rmdcarney/CMBS4_SCSQUID_BiasBoard/pdf/ver3E_headOn.png

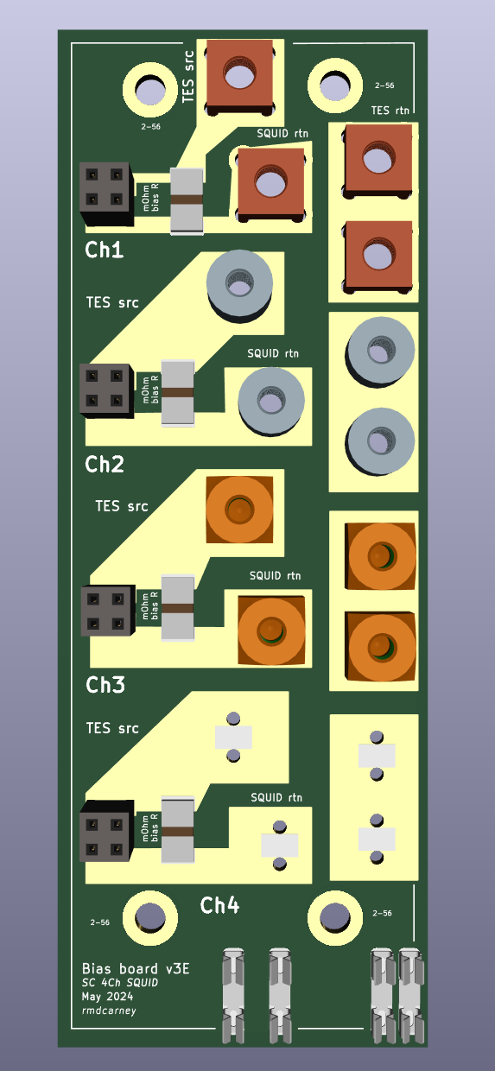
pdf/ver3E_headOn.png
