rmdcarney/CMBS4_SCSQUID_BiasBoard/pdf/ver3E_front.png

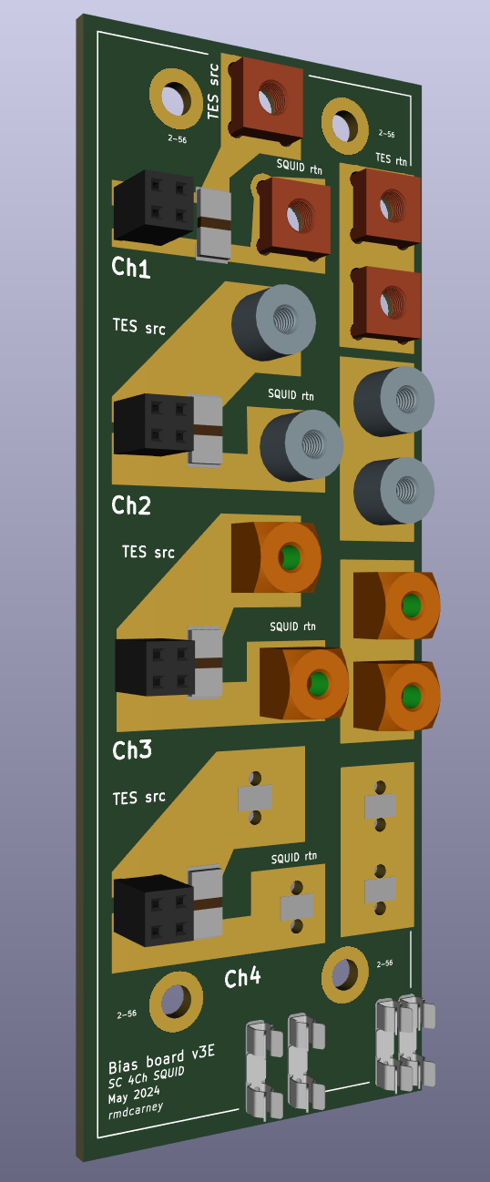
pdf/ver3E_front.png
