rmdcarney/CMBS4_SCSQUID_BiasBoard/pdf/ver3b_front.png

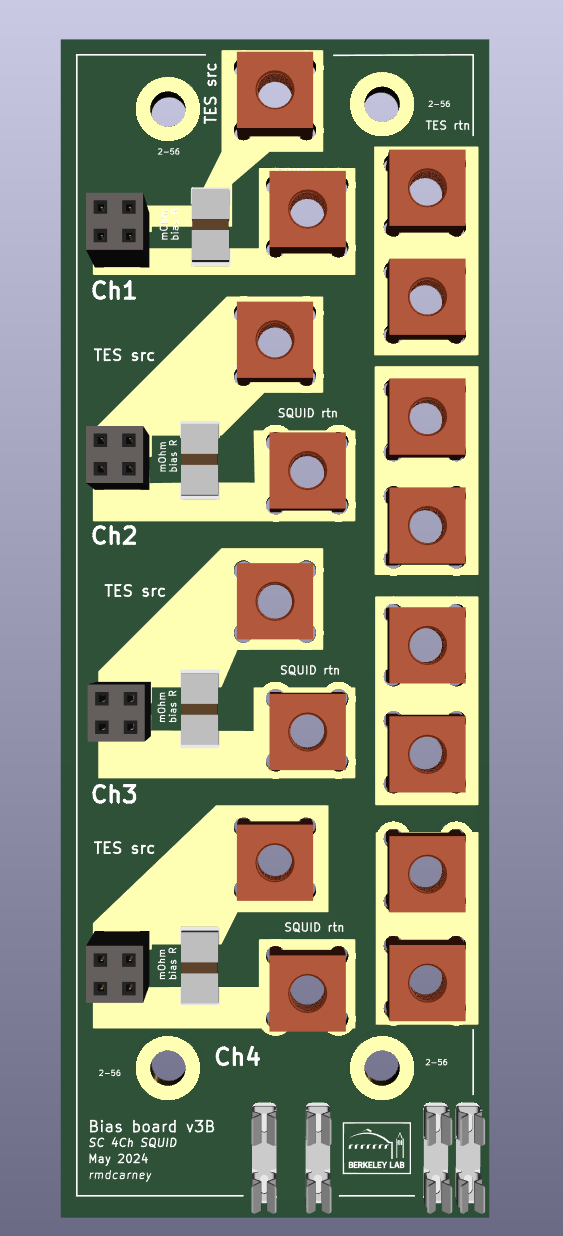
pdf/ver3b_front.png
