rmdcarney/CMBS4_SCSQUID_BiasBoard/pdf/ver3C_front.png

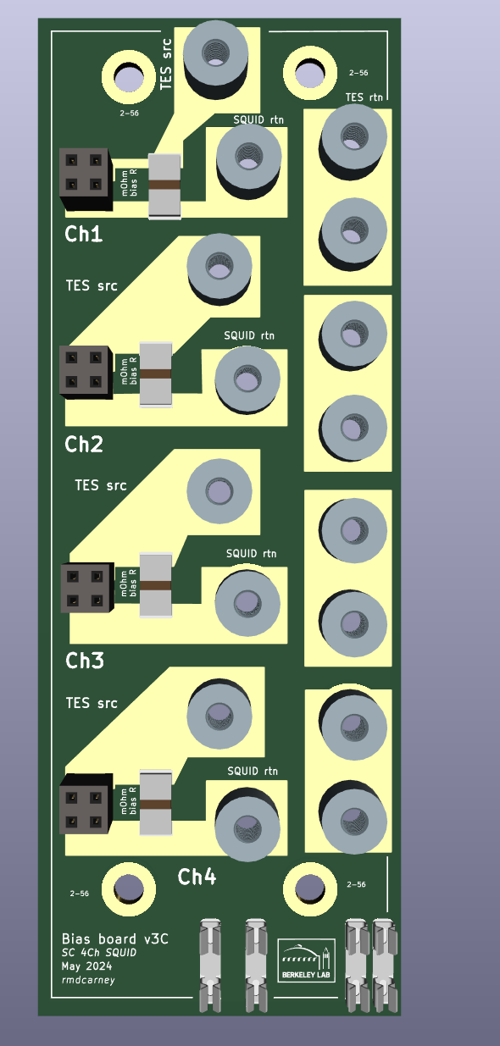
pdf/ver3C_front.png
