rmdcarney/CMBS4_SCSQUID_BiasBoard/pdf/ver3C_front_woConn.png

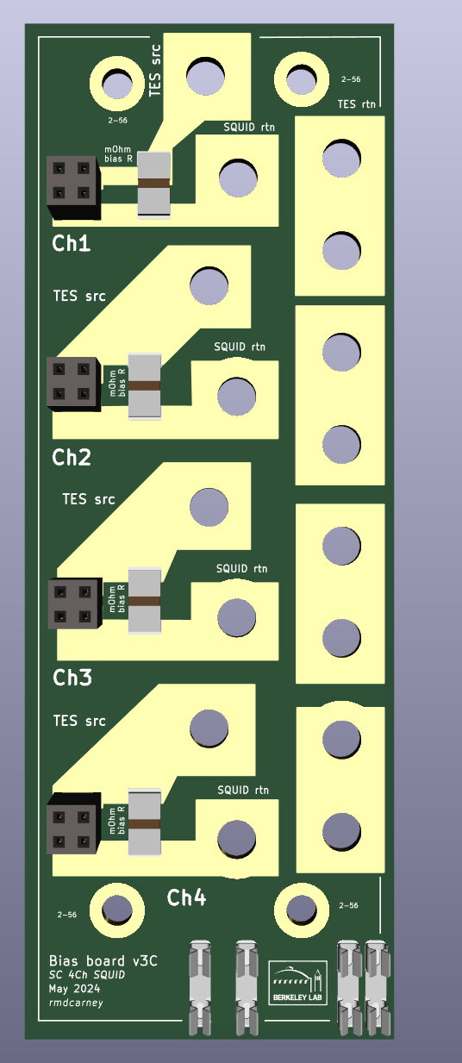
pdf/ver3C_front_woConn.png
