rmdcarney/CMBS4_SCSQUID_BiasBoard/pdf/ver3D_front.png

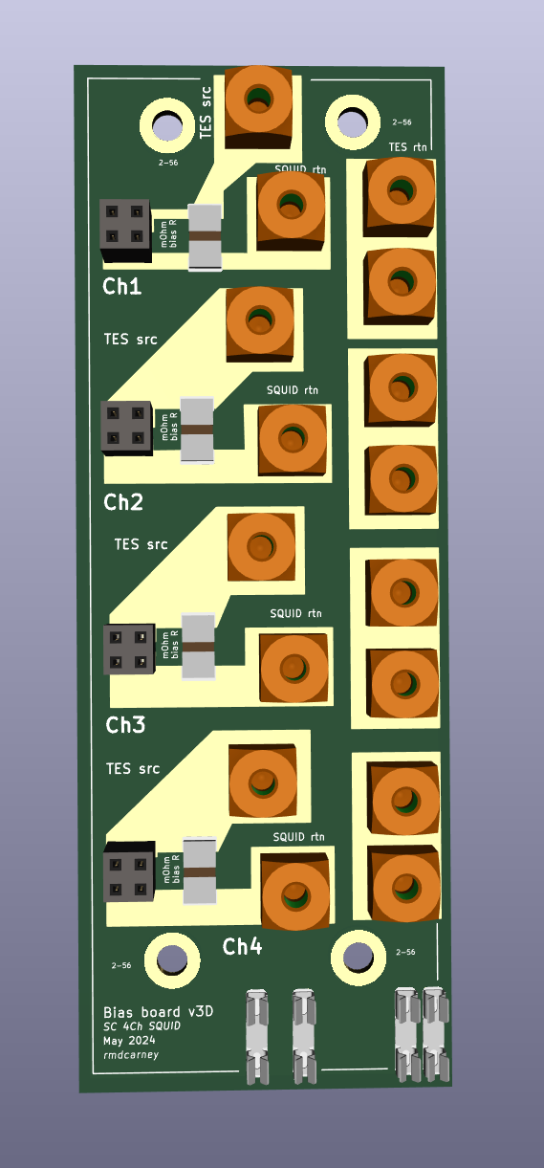
pdf/ver3D_front.png
