rmdcarney/CMBS4_SCSQUID_BiasBoard/pdf/ver3D_front_woConn.png

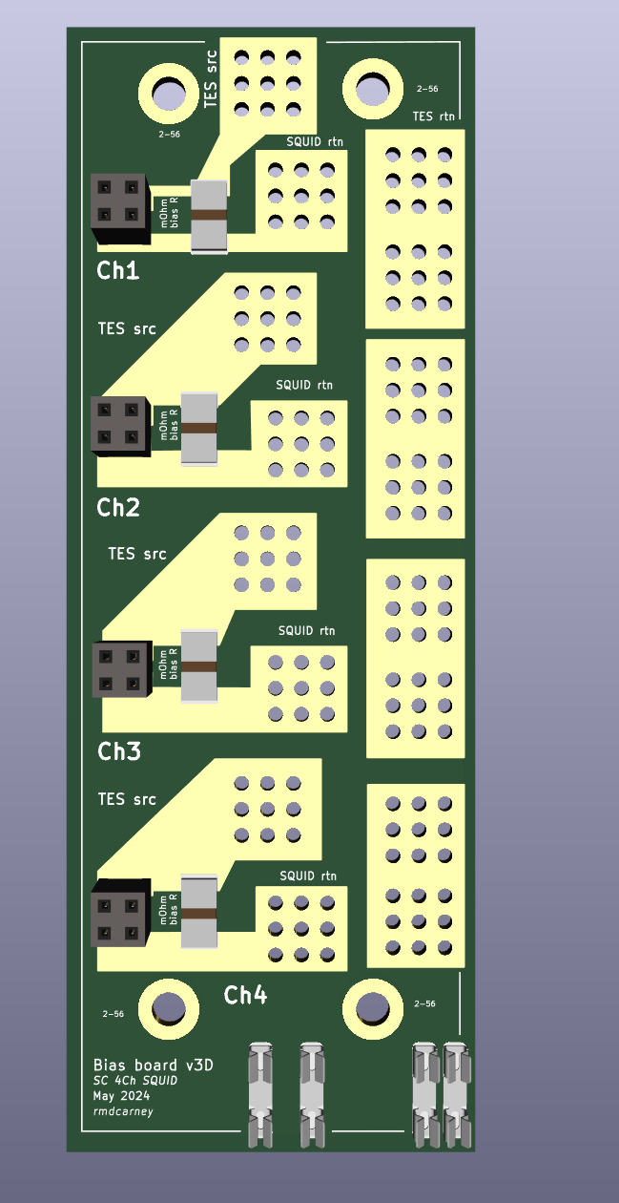
pdf/ver3D_front_woConn.png
