rmdcarney/CMBS4_SCSQUID_BiasBoard/pdf/ver3E_back.png

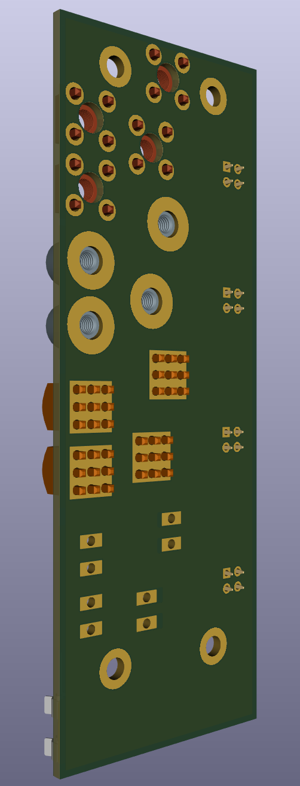
pdf/ver3E_back.png
