rmdcarney/CMBS4_SCSQUID_BiasBoard/3Dmodels/Download_STP_7466003_rev1.stp

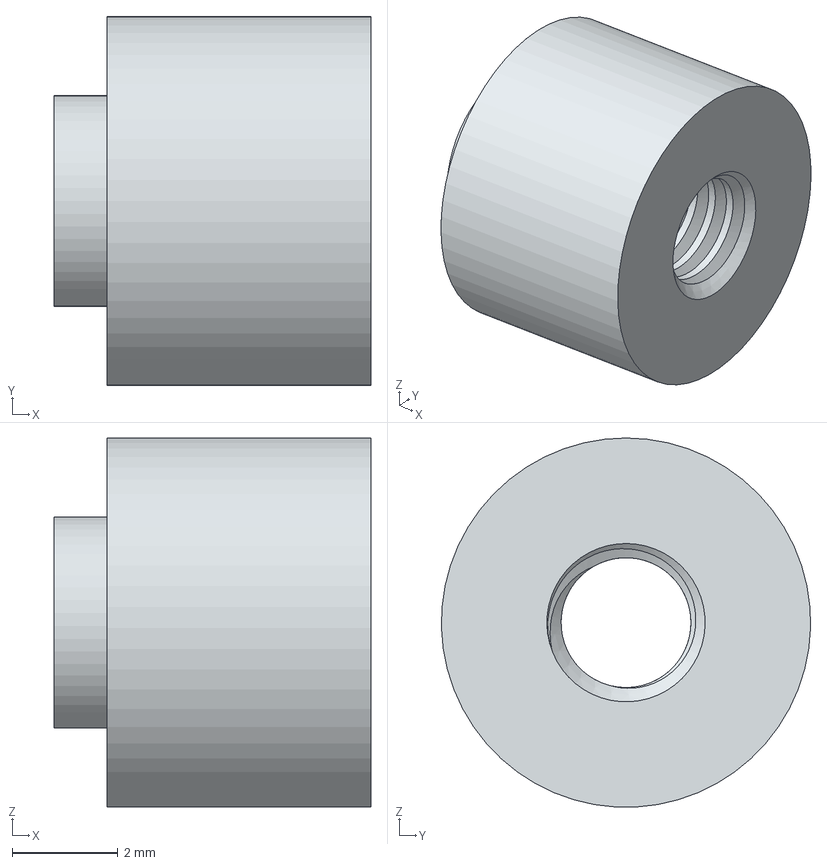
[picture p9: CAD file, 2024-06-01]
3Dmodels/Download_STP_7466003_rev1.stp
6.00 x 7.00 x 6.99 mm
