rmdcarney/CMBS4_SCSQUID_BiasBoard/3Dmodels/s1411-46r_BeBronze.stp

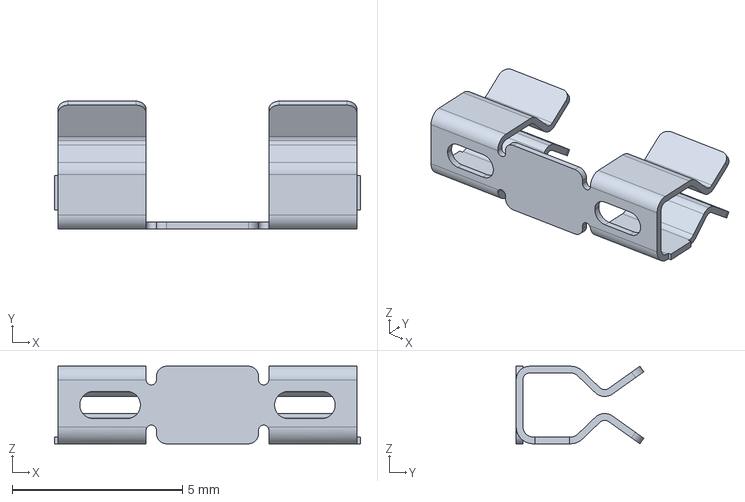
[picture p10: CAD file, 2024-05-31]
3Dmodels/s1411-46r_BeBronze.stp
8.99 x 3.75 x 2.28 mm
