rmdcarney/CMBS4_SCSQUID_BiasBoard/3Dmodels/s8101-46r_cableClipBe.stp

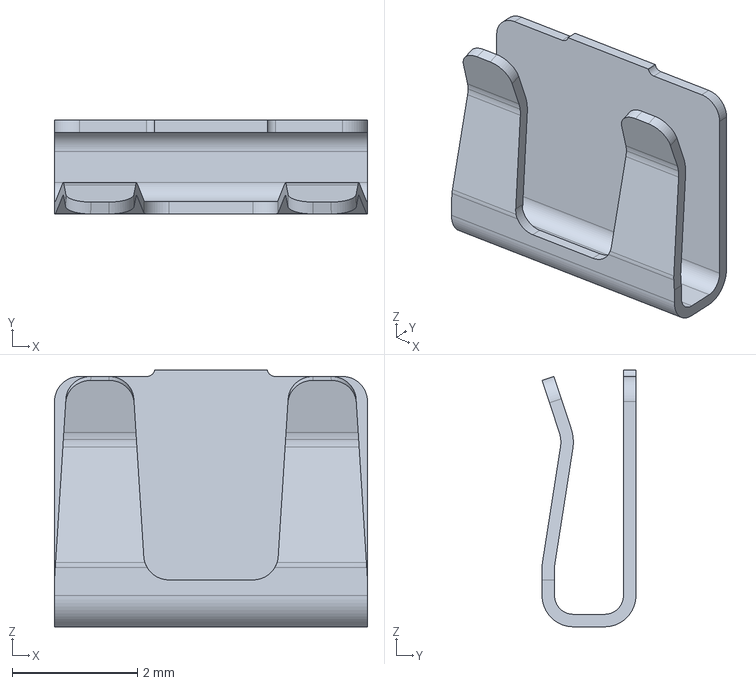
[picture p11: CAD file, 2024-05-31]
3Dmodels/s8101-46r_cableClipBe.stp
5.00 x 1.50 x 4.10 mm
