rmdcarney/CMBS4_SCSQUID_BiasBoard/3Dmodels/SC_SQUID_biasBoard_verA.STEP

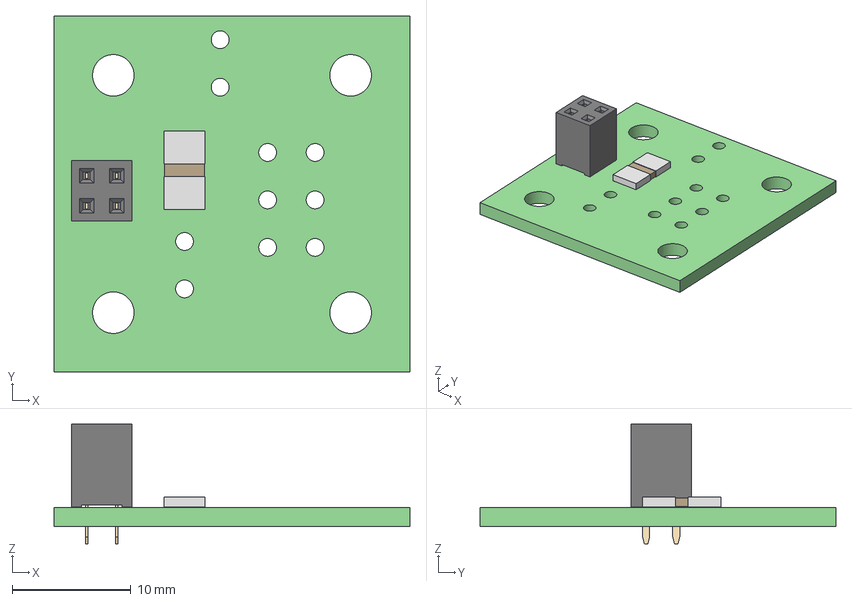
[picture p12: CAD file, 2024-05-31]
3Dmodels/SC_SQUID_biasBoard_verA.STEP
30.0 x 30.0 x 10.1 mm
SC_SQUID_biasBoard PCB
