rmdcarney/CMBS4_SCSQUID_BiasBoard/3Dmodels/RES_SCMM2512__5-_8mOHM_CYN.step

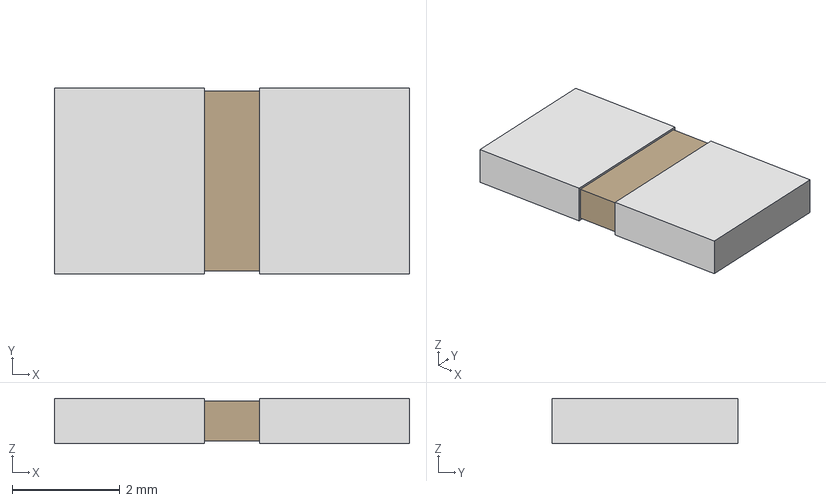
[picture p13: CAD file, 2024-05-31]
3Dmodels/RES_SCMM2512__5-_8mOHM_CYN.step
6.60 x 3.45 x 0.838 mm
