rmdcarney/CMBS4_SCSQUID_BiasBoard/3Dmodels/7461093_Download_STP_7461093_rev1.stp

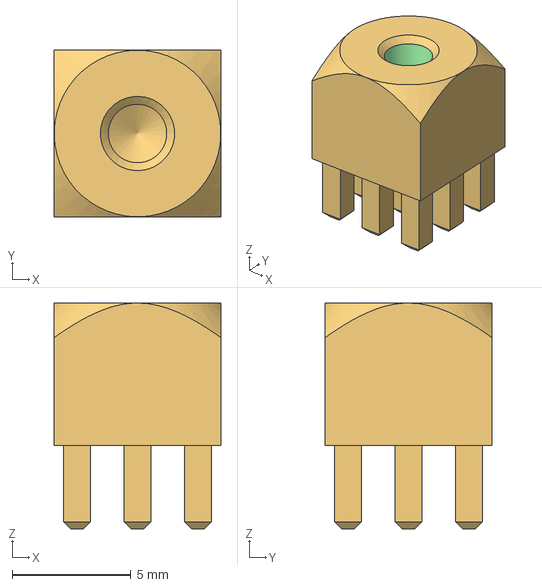
[picture p14: CAD file, 2024-06-01]
3Dmodels/7461093_Download_STP_7461093_rev1.stp
7.00 x 7.00 x 9.50 mm
