rmdcarney/CMBS4_SCSQUID_BiasBoard/3Dmodels/74650073_screwTermLegs.stp

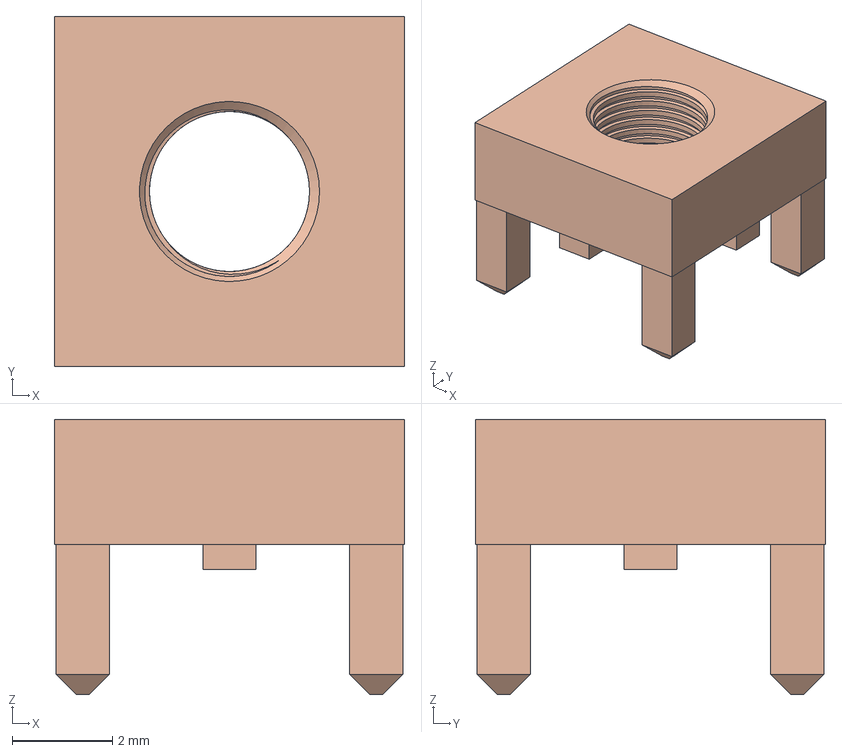
[picture p15: CAD file, 2024-05-31]
3Dmodels/74650073_screwTermLegs.stp
7.00 x 7.00 x 5.50 mm
