rmdcarney/CMBS4_SCSQUID_BiasBoard/gerber/SC_SQUID_biasBoard-F_Silkscreen.pdf

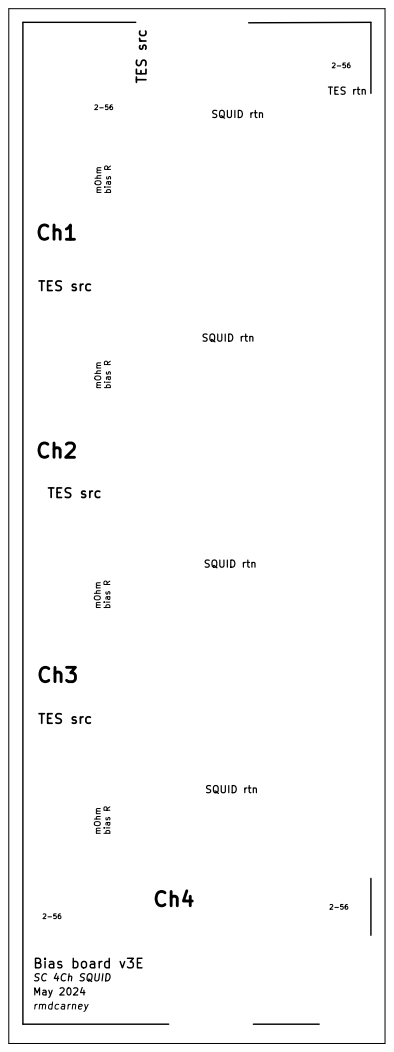
[picture p16: page 1]

2-56 TES src May 2024
TES rtn SQUID rtn Bias board v3E
rmdcarney mOhm bias R Ch3

mOhm bias R SC 4Ch SQUID Ch2
