rmdcarney/CMBS4_SCSQUID_BiasBoard/pdf/SC_SQUID_biasBoard_v3B_4Ch_schematic.pdf

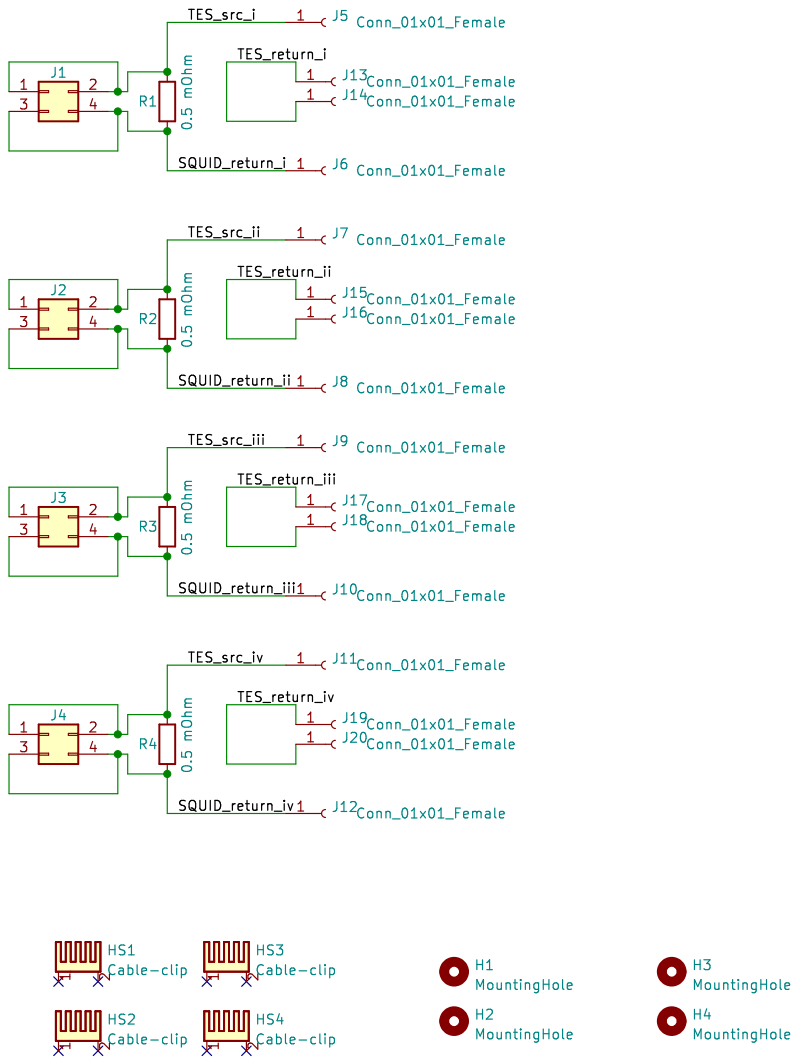
[picture p17: page 1]
