rmdcarney/CMBS4_SCSQUID_BiasBoard/gerber/SC_SQUID_biasBoard-B_Cu.pdf

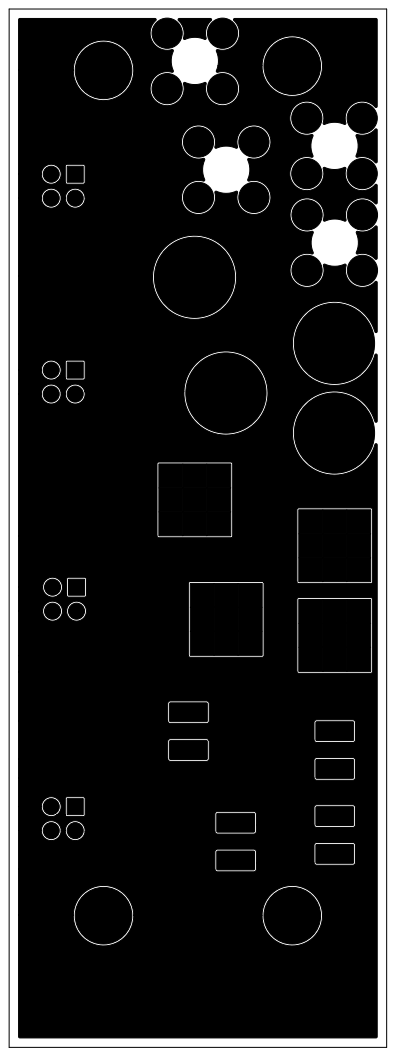
[picture p18: page 1]
