rmdcarney/CMBS4_SCSQUID_BiasBoard/gerber/SC_SQUID_biasBoard-B_Mask.pdf

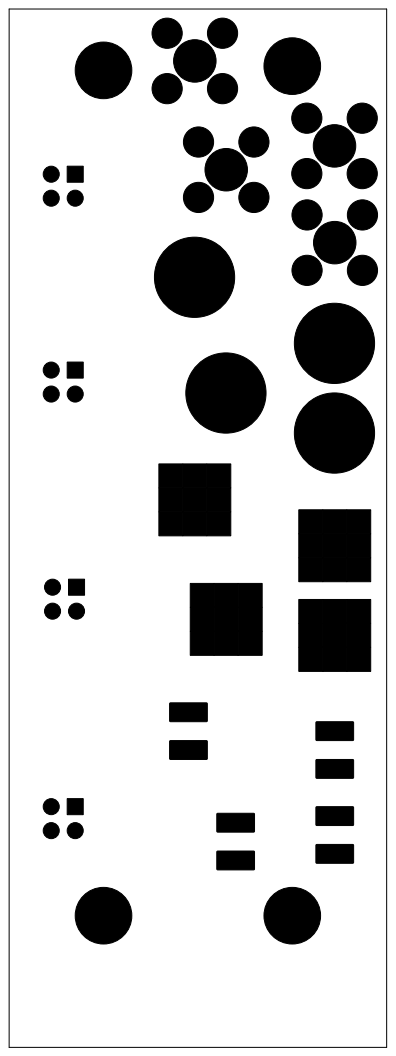
[picture p19: page 1]
