rmdcarney/CMBS4_SCSQUID_BiasBoard/gerber/SC_SQUID_biasBoard-F_Cu.pdf

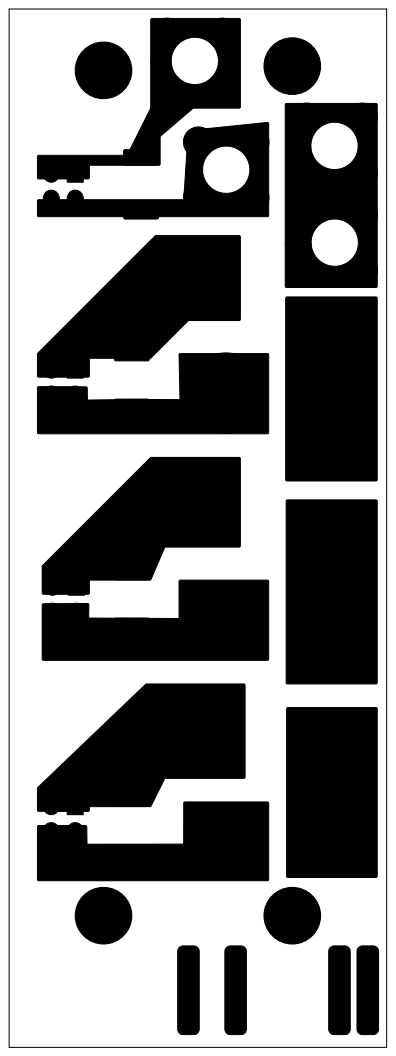
[picture p20: page 1]
