rmdcarney/CMBS4_SCSQUID_BiasBoard/gerber/SC_SQUID_biasBoard-F_Mask.pdf

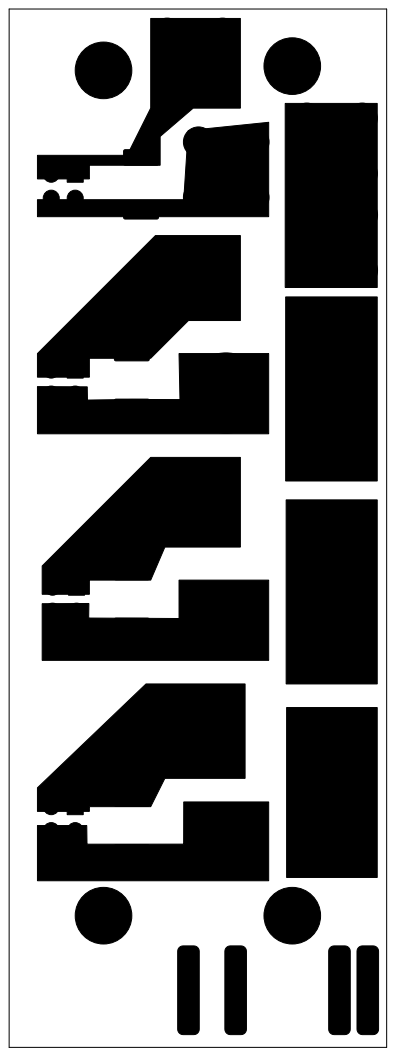
[picture p21: page 1]
