rmdcarney/CMBS4_SCSQUID_BiasBoard/gerber/SC_SQUID_biasBoard-User_Drawings.pdf

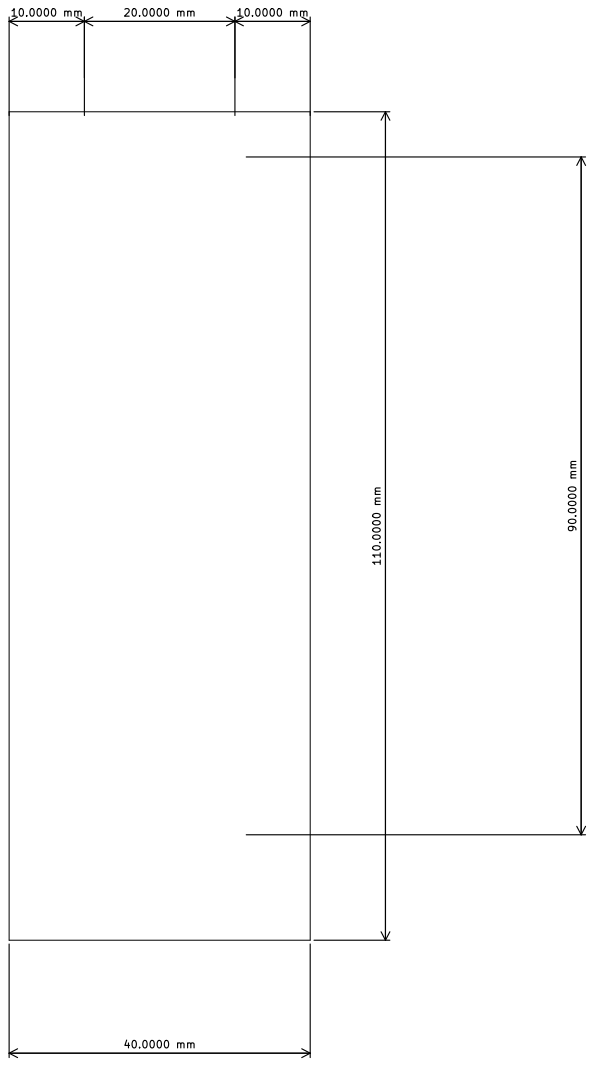
[picture p22: page 1]
