rmdcarney/CMBS4_SCSQUID_BiasBoard/pdf/SC_SQUID_biasBoard_v3D_4Ch_layout.pdf

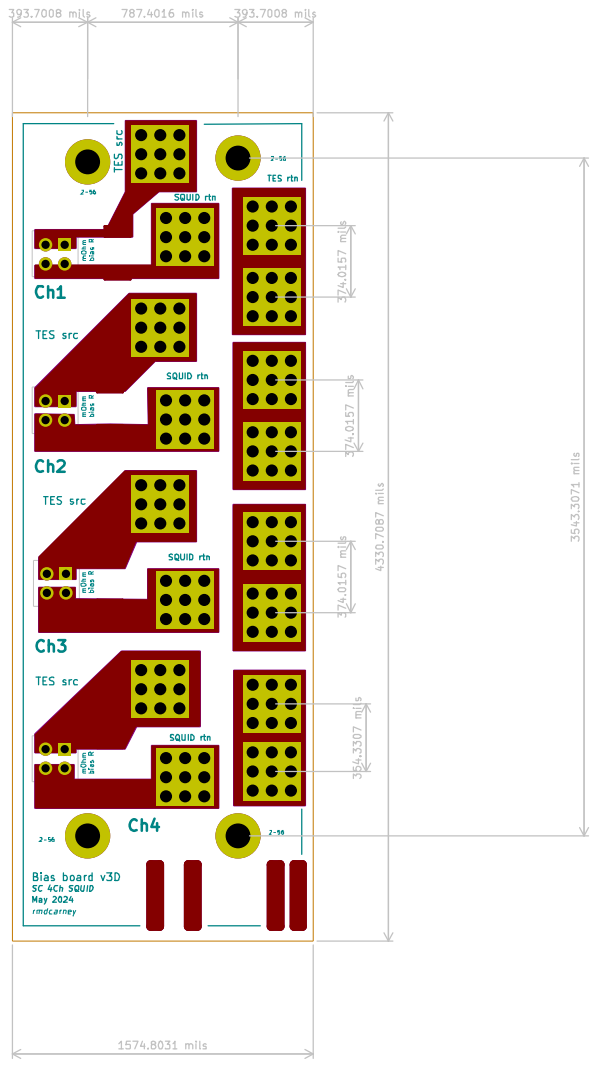
[picture p23: page 1]
