rmdcarney/CMBS4_SCSQUID_BiasBoard/pdf/SC_SQUID_biasBoard_v3D_4Ch_layoutBW.pdf

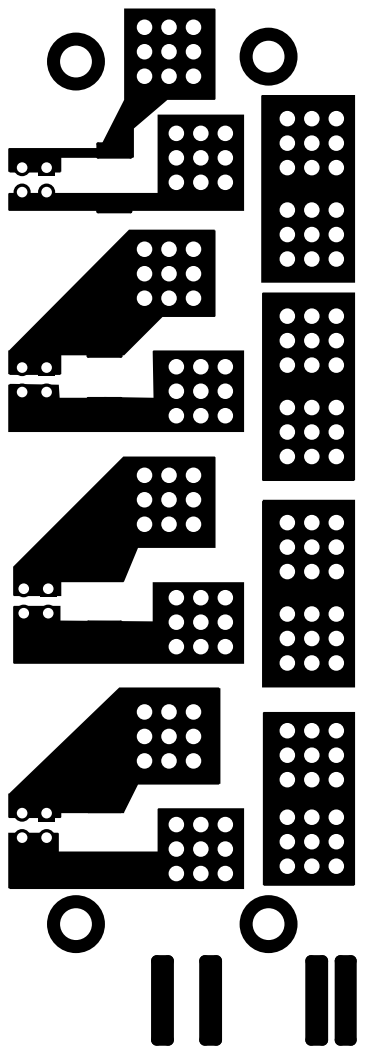
[picture p24: page 1]

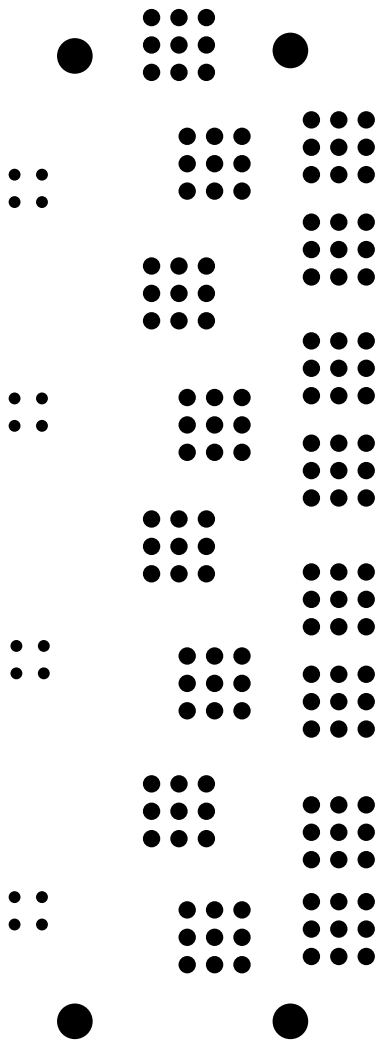
[picture p25: page 2]

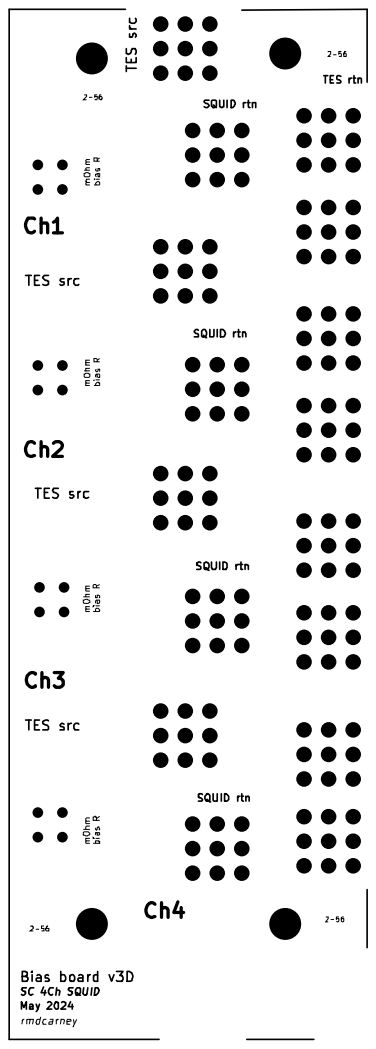
[picture p26: page 3]

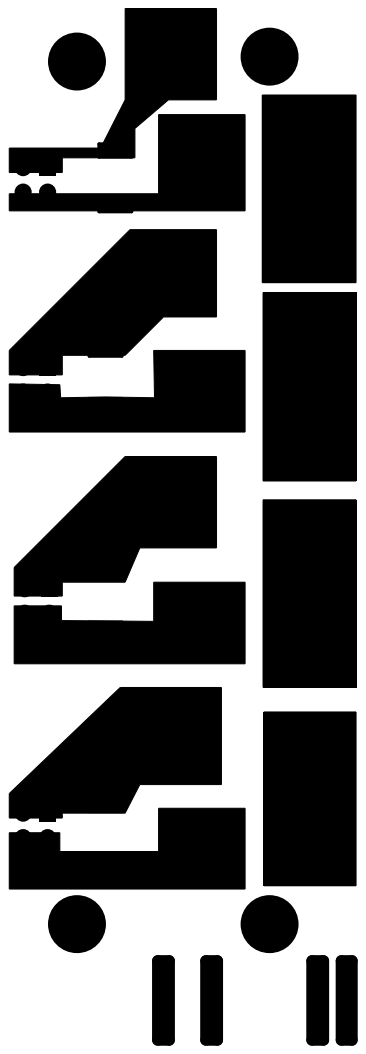
[picture p27: page 4]

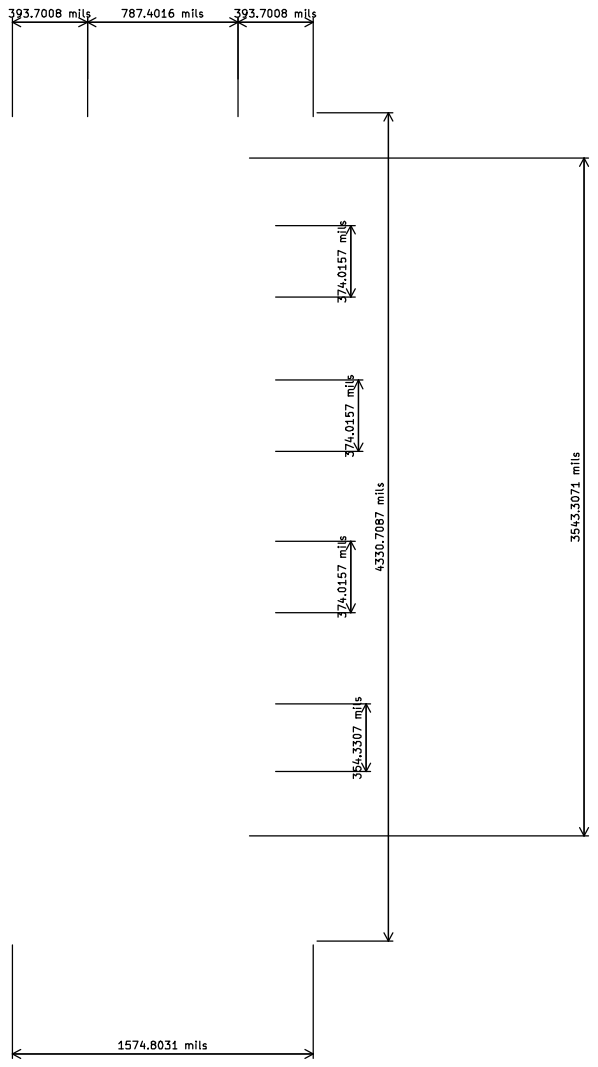
[picture p28: page 5]

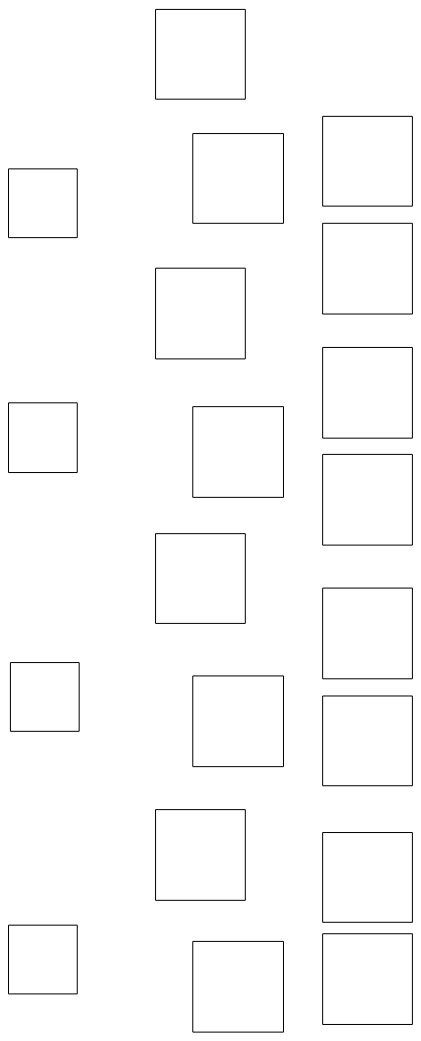
[picture p29: page 7]
