rmdcarney/CMBS4_SCSQUID_BiasBoard/pdf/SC_SQUID_biasBoard_v3B_4Ch_layout.pdf

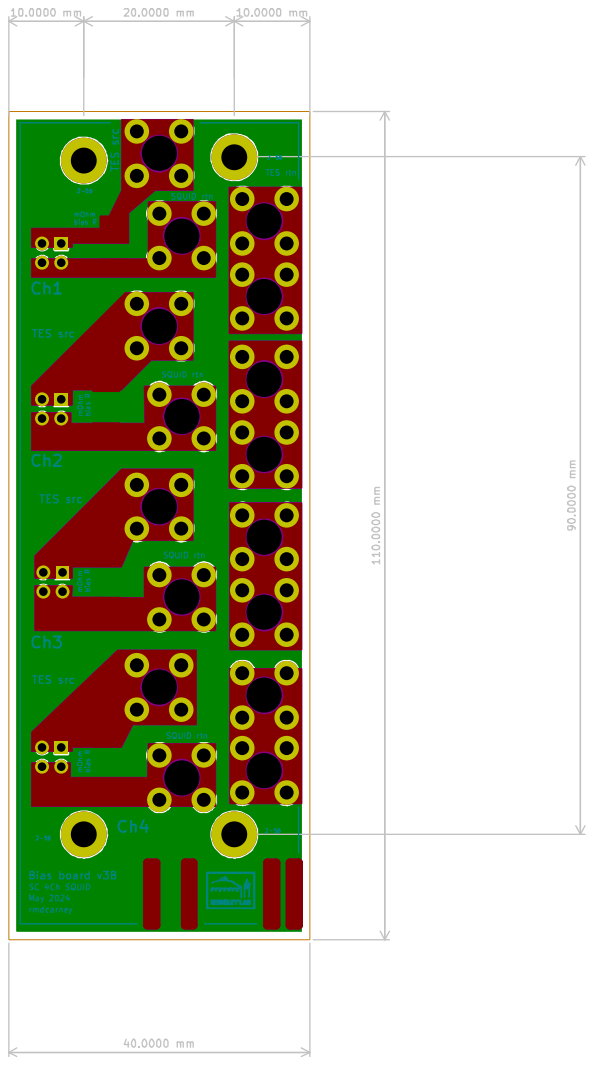
[picture p30: page 1]
