rmdcarney/CMBS4_SCSQUID_BiasBoard/pdf/SC_SQUID_biasBoard_v3B_4Ch_layoutBW.pdf

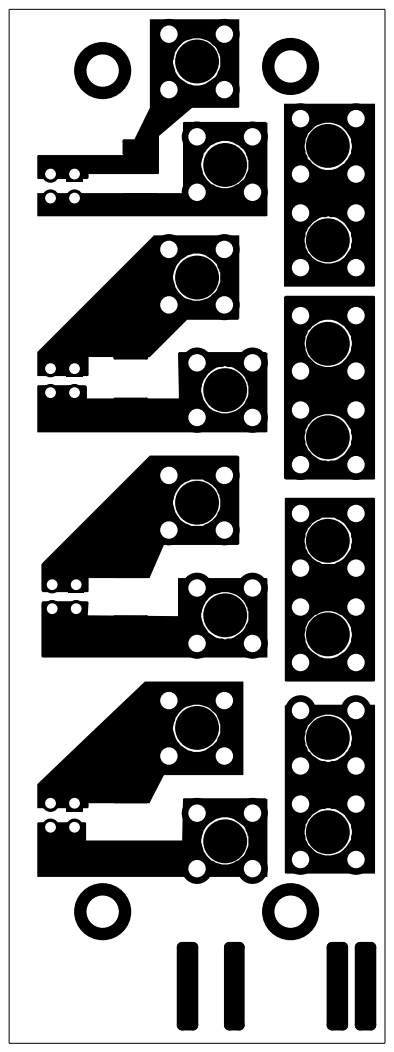
[picture p31: page 1]

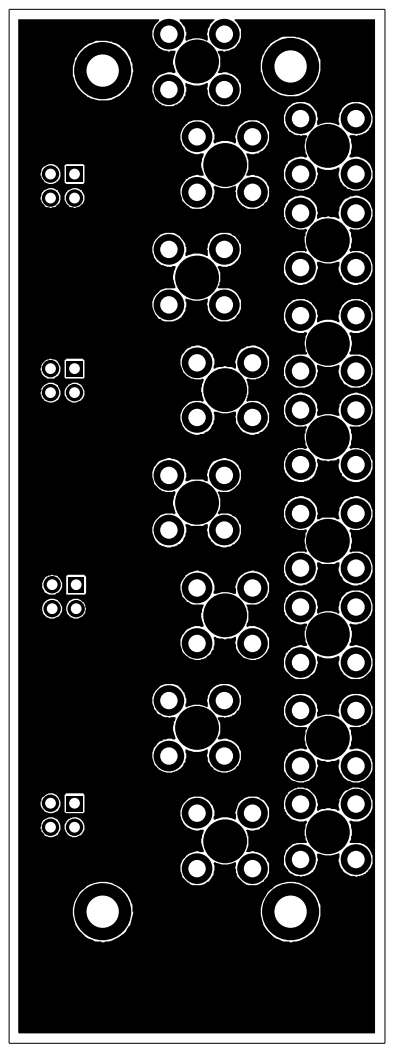
[picture p32: page 2]

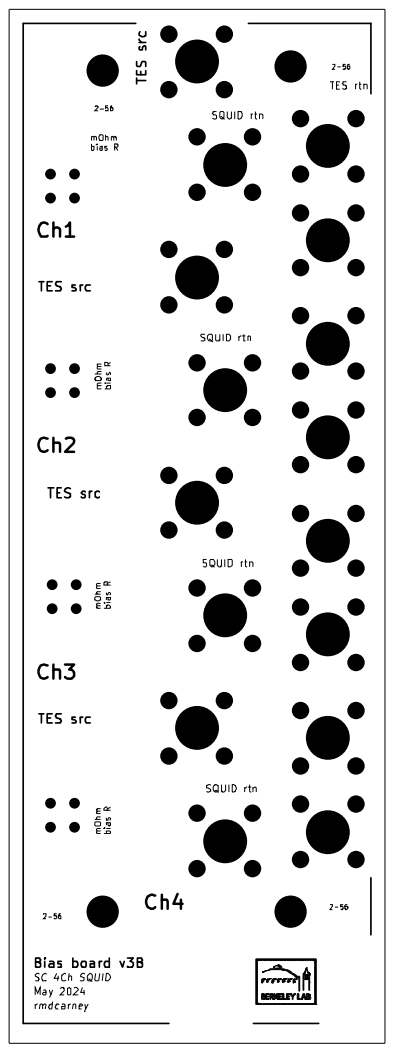
[picture p33: page 3]

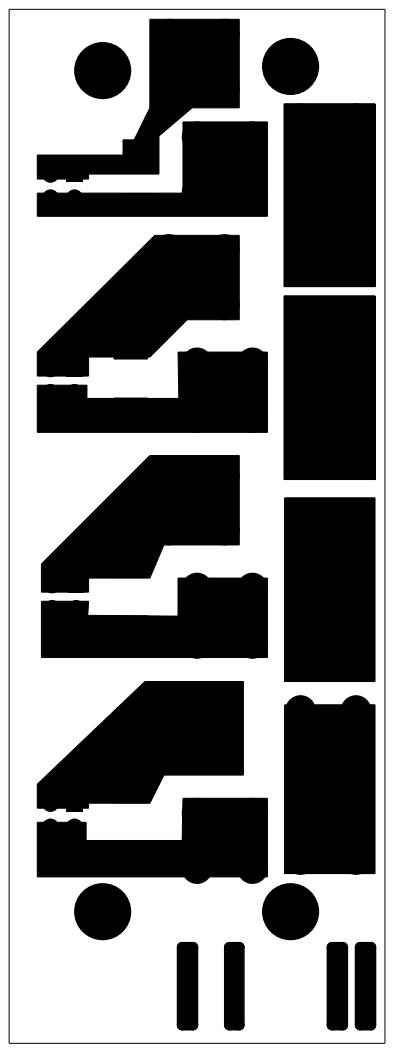
[picture p34: page 4]

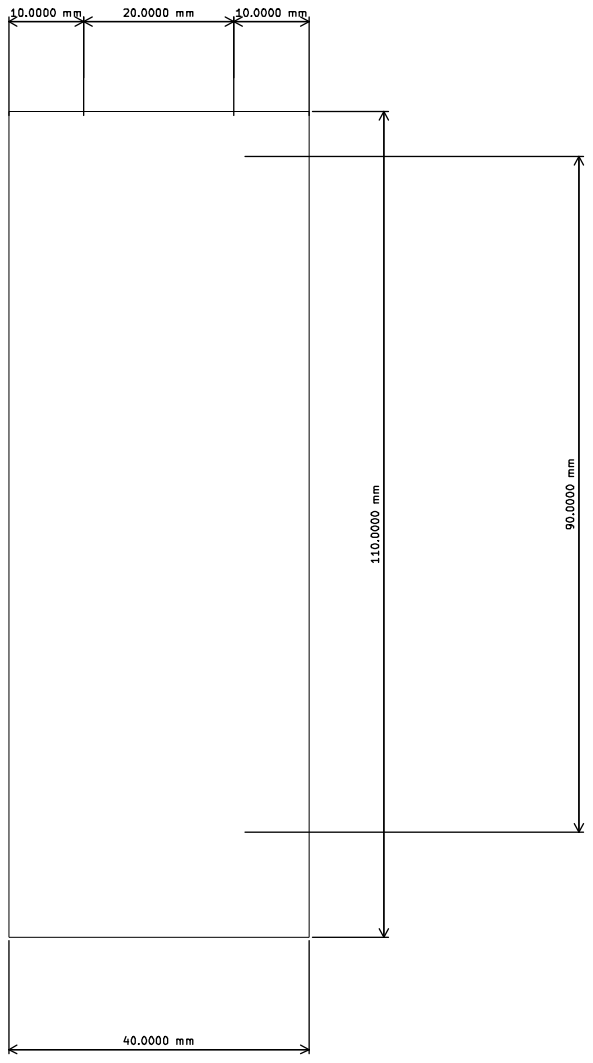
[picture p35: page 5]

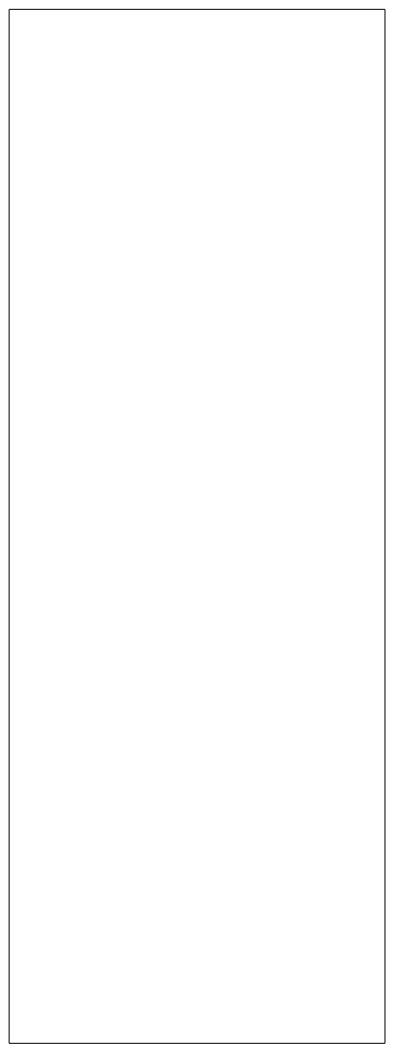
[picture p36: page 6]
