rmdcarney/CMBS4_SCSQUID_BiasBoard/(commit log)

2024-05-20 First commit, empty
    [SC_SQUID_biasBoard.kicad_pcb, SC_SQUID_biasBoard.kicad_sch]
2024-05-29 Added footprint and symbol library
2024-05-31 Version A: first draft. Ready for final checks before submission
    [RES_SCMM2512__5-_8mOHM_CYN.step, SC_SQUID_biasBoard.kicad_pcb, SC_SQUID_biasBoard.kicad_sch]
2024-05-31 Trying with a larger board.
    [74650073_screwTermLegs.stp, SC_SQUID_biasBoard.kicad_pcb, SC_SQUID_biasBoard.kicad_sch, SC_SQUID_biasBoard_verA.STEP]
2024-05-31 So close to being done, screwwedup the direction of the headroom. Will fix.
    [SC_SQUID_biasBoard.kicad_pcb, SC_SQUID_biasBoard.kicad_sch, s1411-46r_BeBronze.stp, s8101-46r_cableClipBe.stp]
2024-06-01 Version 3B.1 is complete. Now moving onto next version.
    [SC_SQUID_biasBoard.kicad_pcb]
2024-06-01 Version 3C.1 drafted
    [SC_SQUID_biasBoard.kicad_pcb, SC_SQUID_biasBoard.kicad_sch]
2024-06-01 Version 3D with press fit screw terminal first verison.
    [SC_SQUID_biasBoard.kicad_pcb, SC_SQUID_biasBoard.kicad_sch]
2024-06-01 Added 3D model
    [7461093_Download_STP_7461093_rev1.stp, SC_SQUID_biasBoard.kicad_pcb]
2024-06-01 Fixed the first channel traces and added 3D model.
    [Download_STP_7466003_rev1.stp]
2024-06-01 Version submitted for fab.
    [SC_SQUID_biasBoard-B_Cu.gbr, SC_SQUID_biasBoard-B_Mask.gbr, SC_SQUID_biasBoard-Edge_Cuts.gbr, SC_SQUID_biasBoard-F_Cu.gbr, SC_SQUID_biasBoard-F_Mask.gbr, SC_SQUID_biasBoard-F_Silkscreen.gbr, SC_SQUID_biasBoard-NPTH.drl, SC_SQUID_biasBoard-PTH.drl]
